tapsterbot/tapsterbot/hardware/tapster-2/stl/stylus-holder.stl

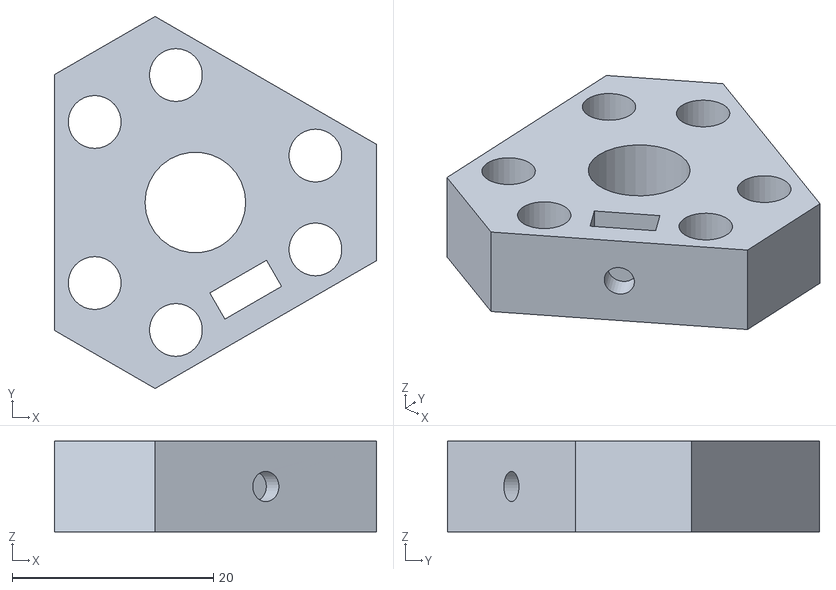
[picture p1: CAD file, 2019-03-05]
hardware/tapster-2/stl/stylus-holder.stl
32.0 x 37.0 x 9.00
