tapsterbot/tapsterbot/(commit log)

2015-06-30 Kinematics is now configurable.
2015-06-30 ik.js is now kinematics.js
2015-07-17 Cleanup
    Bot.js pulls in motion.js; cleaned up SVGReader and Draw; fixed some
    hello files; added some config values
    [bot.js]
2015-07-28 *Switch* to switch statements
    heh
    Also some misc. cleanup
2019-03-05 New center width for stylus holder
    [stylus-holder.scad]
2019-03-18 Tighter tolerance for the magnets.
    [stylus-holder.scad]
